maarten-pennings/mRPM/wiring/README.md

# mRPM - Wiring
The wiring of Maarten's RPM meter

## Introduction
This project consists of a sensor, a LED matrix and an ESP8266. 
See the [main](../README.md) page for details on these components.
This page explains how to connect them.

The sensor and the matrix need to be connected to the ESP8266.
 - The _sensor_ has three pins: power (VCC 5V, GND) and a digital out (DO).
 - The _LED matrix_ is more complicated with its 5 pins; it has power (VCC 3V3, GND), data in (DIN), clock (CLK) and chip select (CS).

## Power
The ESP8266 is typically powered over USB (5V) from a power bank; the matrix and sensor are powered from the ESP8266 board.
The ESP8266 board has an LDO to convert 5V to 3V3 and it has some pins to output 3V3, one of which connects to the LED matrix.
The sensor needs 5V. Unfortunately, the chosen ESP8266 board does not have a 5V out (directly form the USB). 
It does have a VIN which is connected to VUSB via a Schottky, so we use that instead.

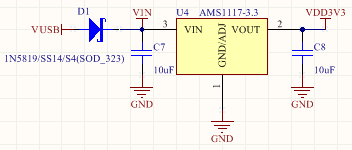
[picture p3: wiring/VIN.png]
VUSB to VIN
  

Some ESP8266 boards do have VUSB out.

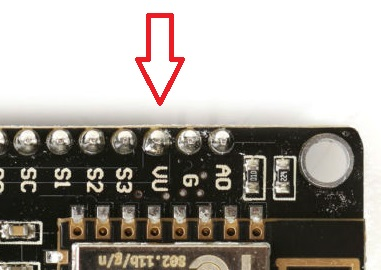
[picture p4: wiring/VU.jpg]
VUSB out pin
  

## Schematics
The overall schematics are as follows

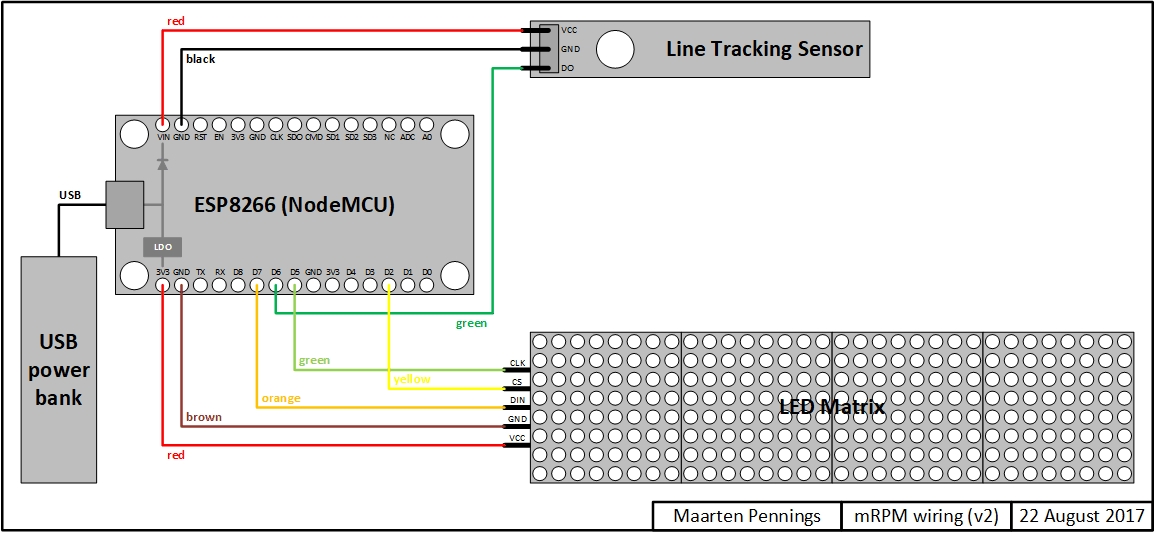
[picture p5: wiring/1schematics.jpg]
Schematics
  

The wiring instructions are also described in a [text file](2wiring.txt).

## ESP8266 to matrix
The connection between the ESP8266 and the matrix is shown in two photos, ESP8266 side and matrix side:

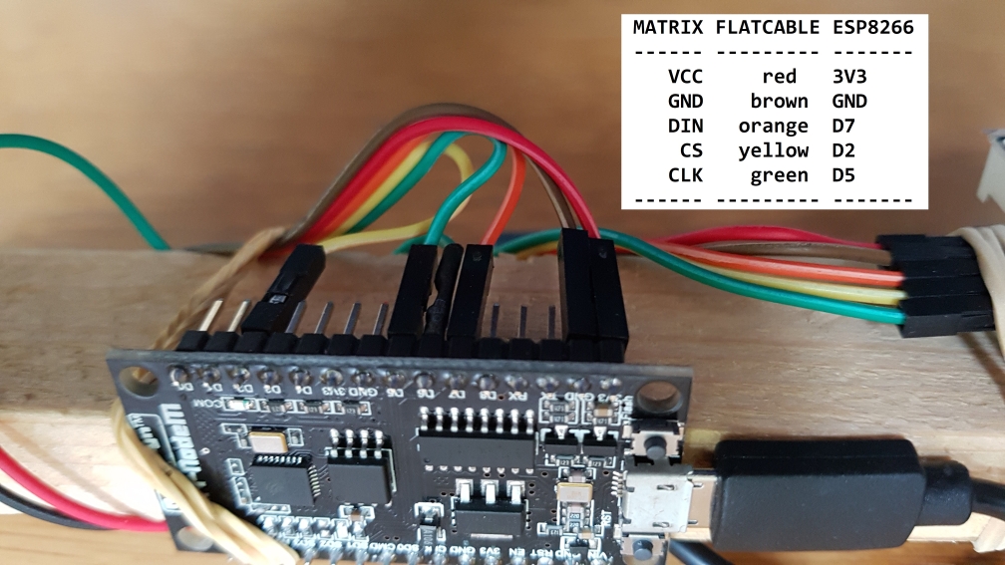
[picture p6: wiring/3esp-matrix.jpg]
ESP8266 to Matrix connection
  
  
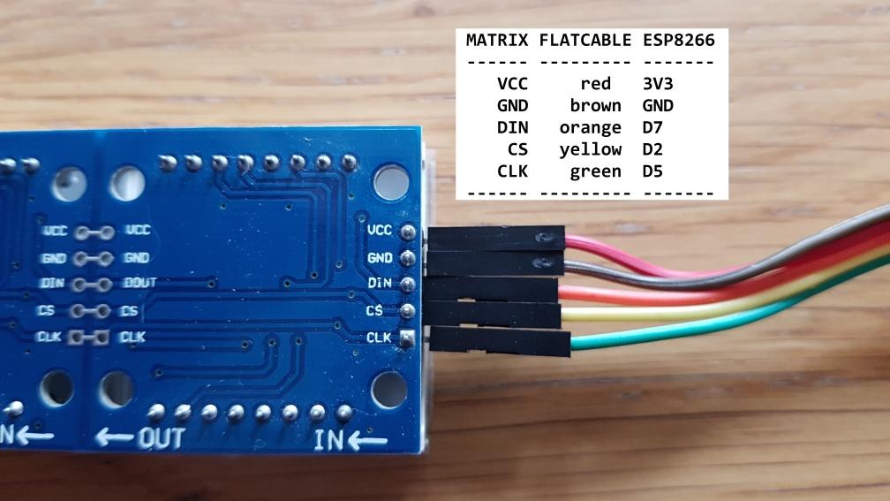
[picture p7: wiring/3matrix-esp.jpg]
Matrix to ESP8266 connection
  

## ESP8266 to sensor
The connection between the ESP8266 and the sensor is shown in two photos, ESP8266 side and sensor side:

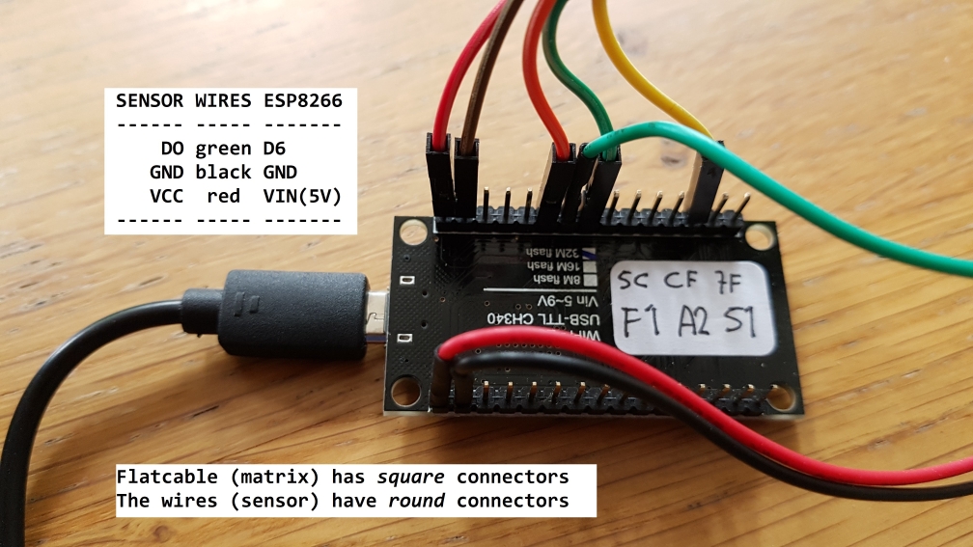
[picture p8: wiring/4esp-sensor.jpg]
  
  
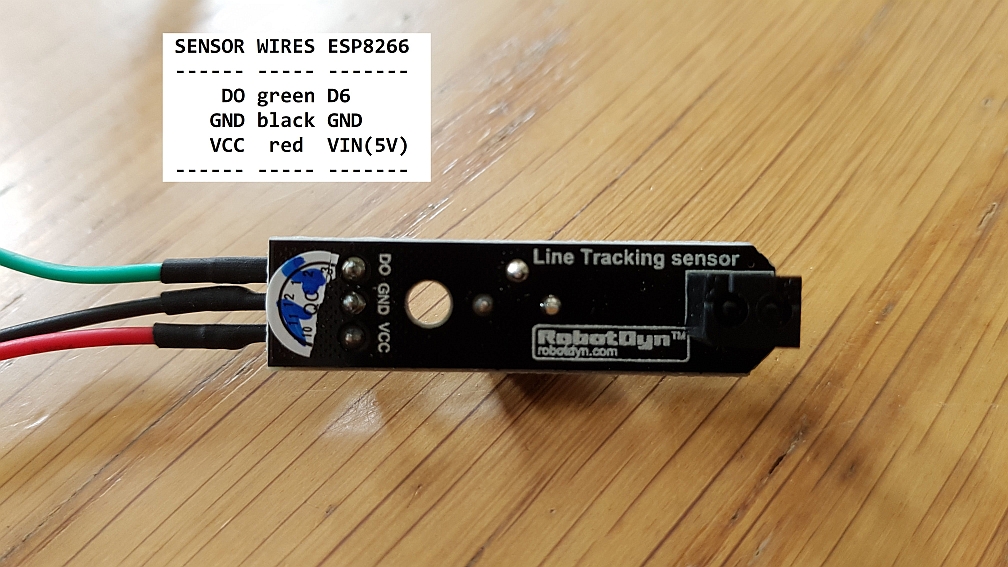
[picture p9: wiring/4sensor-esp.jpg]
  

## Matrix not working
Some of the LED matrices appeared not to work.
They show a blocky pattern like in the photo below.

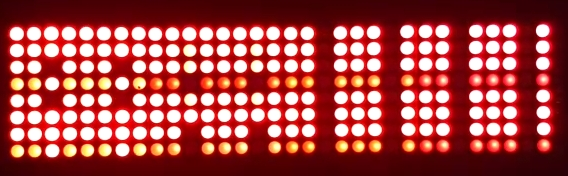
[picture p10: wiring/MatrixError.jpg]
LED matrix not working
  
  
It turned out that the 8x8 modules are inserted up-side-down.
When the LEDs are facing upwards, and the input is on the right hand side, 
the printed serial number on the module should be at the bottom as shown in the photo below.

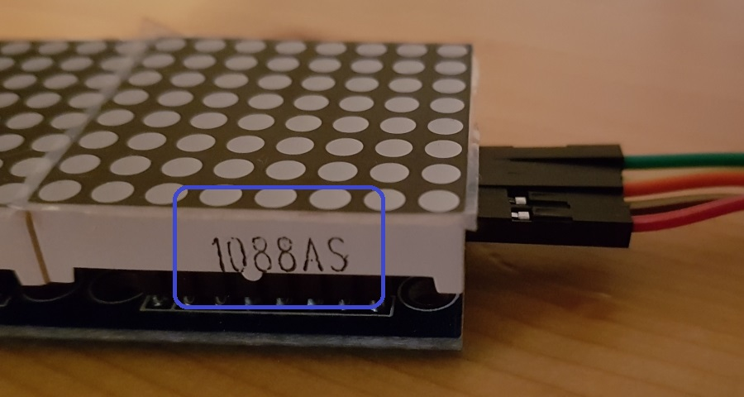
[picture p11: wiring/MatrixOrientation.jpg]
LED matrix not working
  

## Firmware
Next step is to flash the [firmware](../arduino) via the Arduino IDE.

(end of doc)
