maarten-pennings/mRPM/arduino/mRPM/MAX7219_Dot_Matrix_font.h

// From: Nick Gammon
// Updated by: Maarten Pennings (fatter i,l etc, digits with dots)

// bit patterns for the CP437 font

const byte MAX7219_Dot_Matrix_font [256] [8]  = {
  { 0x00, 0x00, 0x00, 0x00, 0x00, 0x00, 0x00, 0x00 }, // 0x00
  { 0x7E, 0x81, 0x95, 0xB1, 0xB1, 0x95, 0x81, 0x7E }, // 0x01
  { 0x7E, 0xFF, 0xEB, 0xCF, 0xCF, 0xEB, 0xFF, 0x7E }, // 0x02
  { 0x0E, 0x1F, 0x3F, 0x7E, 0x3F, 0x1F, 0x0E, 0x00 }, // 0x03
  { 0x08, 0x1C, 0x3E, 0x7F, 0x3E, 0x1C, 0x08, 0x00 }, // 0x04
  { 0x18, 0xBA, 0xFF, 0xFF, 0xFF, 0xBA, 0x18, 0x00 }, // 0x05
  { 0x10, 0xB8, 0xFC, 0xFF, 0xFC, 0xB8, 0x10, 0x00 }, // 0x06
  { 0x00, 0x00, 0x18, 0x3C, 0x3C, 0x18, 0x00, 0x00 }, // 0x07
  { 0xFF, 0xFF, 0xE7, 0xC3, 0xC3, 0xE7, 0xFF, 0xFF }, // 0x08
  { 0x00, 0x3C, 0x66, 0x42, 0x42, 0x66, 0x3C, 0x00 }, // 0x09
  { 0xFF, 0xC3, 0x99, 0xBD, 0xBD, 0x99, 0xC3, 0xFF }, // 0x0A
  { 0x70, 0xF8, 0x88, 0x88, 0xFD, 0x7F, 0x07, 0x0F }, // 0x0B
  { 0x00, 0x4E, 0x5F, 0xF1, 0xF1, 0x5F, 0x4E, 0x00 }, // 0x0C
  { 0xC0, 0xE0, 0xFF, 0x7F, 0x05, 0x05, 0x07, 0x07 }, // 0x0D
  { 0xC0, 0xFF, 0x7F, 0x05, 0x05, 0x65, 0x7F, 0x3F }, // 0x0E
  { 0x99, 0x5A, 0x3C, 0xE7, 0xE7, 0x3C, 0x5A, 0x99 }, // 0x0F 
  { 0x3E, 0x7F, 0x71, 0x59, 0x4D, 0x7F, 0xFE, 0xC0 }, // '0.' // Maarten: replaced chars 0x10..0x19 with digits that have a trailing decimal dot.
  { 0x40, 0x42, 0x7F, 0x7F, 0x40, 0x40, 0xC0, 0xC0 }, // '1.'
  { 0x62, 0x73, 0x59, 0x49, 0x6F, 0x66, 0xC0, 0xC0 }, // '2.'
  { 0x22, 0x63, 0x49, 0x49, 0x7F, 0x36, 0xC0, 0xC0 }, // '3.'
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
  { 0x01, 0x45, 0x7C, 0x7C, 0x41, 0x01, 0x00, 0x00 }, // 0x8B
  { 0x02, 0x03, 0x45, 0x7D, 0x7D, 0x43, 0x02, 0x00 }, // 0x8C
  { 0x01, 0x45, 0x7D, 0x7C, 0x40, 0x00, 0x00, 0x00 }, // 0x8D
  { 0x79, 0x7D, 0x16, 0x12, 0x16, 0x7D, 0x79, 0x00 }, // 0x8E
  { 0x70, 0x78, 0x2B, 0x2B, 0x78, 0x70, 0x00, 0x00 }, // 0x8F
  { 0x44, 0x7C, 0x7C, 0x55, 0x55, 0x45, 0x00, 0x00 }, // 0x90
  { 0x20, 0x74, 0x54, 0x54, 0x7C, 0x7C, 0x54, 0x54 }, // 0x91
  { 0x7C, 0x7E, 0x0B, 0x09, 0x7F, 0x7F, 0x49, 0x00 }, // 0x92
  { 0x32, 0x7B, 0x49, 0x49, 0x7B, 0x32, 0x00, 0x00 }, // 0x93
  { 0x32, 0x7A, 0x48, 0x48, 0x7A, 0x32, 0x00, 0x00 }, // 0x94
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
};  //  end of MAX7219_Dot_Matrix_font
