maarten-pennings/mRPM/(commit log)

2017-07-23 Added wiring
2017-07-23 readme for wiring
2017-07-23 Added wiring and arduino link
2017-07-23 Updated arduino instructions
2017-07-23 Added driver
2017-08-03 Added LED matrix error
2017-08-20 Improved ISR (spike times no longer ignored)
    [MAX7219_Dot_Matrix_font.h, mRPM.ino]
2017-08-21 v4: Enabled low power (wifi off), added version
2017-08-21 Added link to flash.md from arduino/README.md
2017-08-22 Updated schematics
2018-07-19 Update README.md
    Board selection
